goran-mahovlic/ulx3s-extensions/OV7670/OV7670.kicad_pcb

## KiCad design OV7670/OV7670.kicad_pcb (2023-08-24)

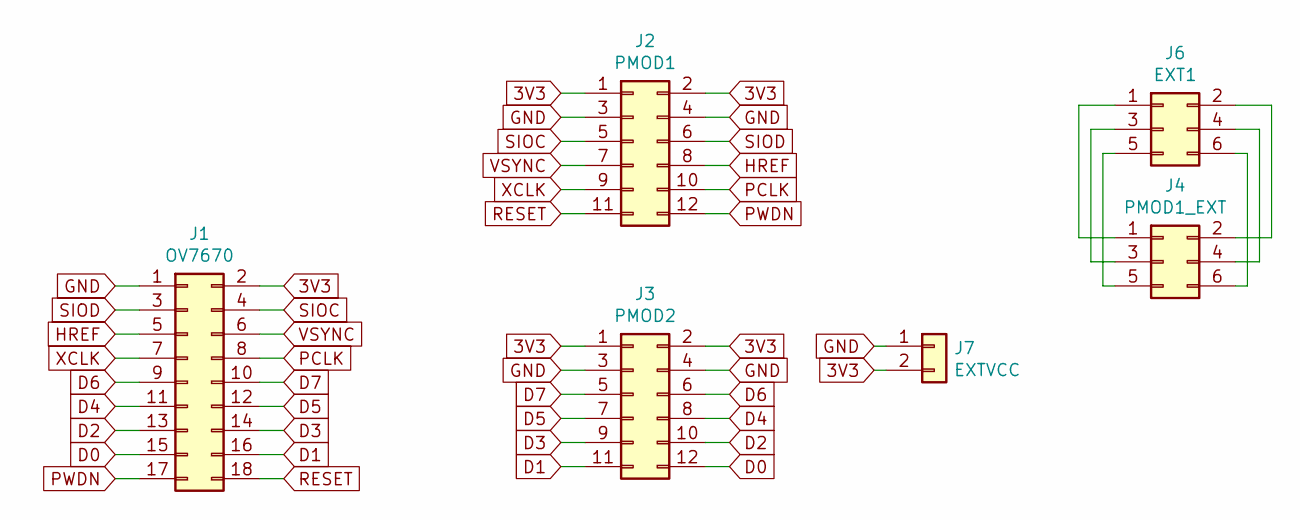
[picture p3: schematic OV7670.kicad_sch]

Parts:
J1: OV7670; PinSocket_2x09_P2.54mm_Vertical
J2: PMOD1; PinHeader_2x06_P2.54mm_Horizontal
J3: PMOD2; PinHeader_2x06_P2.54mm_Horizontal
J4: PMOD1_EXT; PinHeader_2x03_P2.54mm_Horizontal
J6: EXT1; PinHeader_2x03_P2.54mm_Vertical
J7: EXTVCC; PinHeader_1x02_P2.54mm_Vertical

Connections:
3V3: J1.2, J2.1, J2.2, J3.1, J3.2, J7.2
D0: J1.15, J3.12
D1: J1.16, J3.11
D2: J1.13, J3.10
D3: J1.14, J3.9
D4: J1.11, J3.8
D5: J1.12, J3.7
D6: J1.9, J3.6
D7: J1.10, J3.5
GND: J1.1, J2.3, J2.4, J3.3, J3.4, J7.1
HREF: J1.5, J2.8
unnamed: J4.1, J6.1
unnamed: J4.2, J6.2
unnamed: J4.3, J6.3
unnamed: J4.4, J6.4
unnamed: J4.5, J6.5
unnamed: J4.6, J6.6
PCLK: J1.8, J2.10
PWDN: J1.17, J2.12
RESET: J1.18, J2.11
SIOC: J1.4, J2.5
SIOD: J1.3, J2.6
VSYNC: J1.6, J2.7
XCLK: J1.7, J2.9

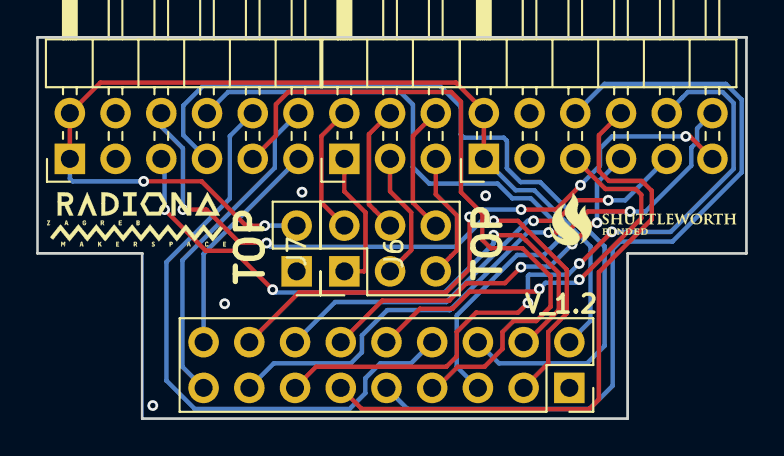
[picture p4: board OV7670.kicad_pcb from above]

Board: 4 copper layers, 39.4 x 21.2 mm, 6 parts (0 on the bottom side), 24 nets.
