goran-mahovlic/ulx3s-extensions/GPDI_ULX3S/GPDI_ULX3S.kicad_pcb

## KiCad design GPDI_ULX3S/GPDI_ULX3S.kicad_pcb (2023-08-23)

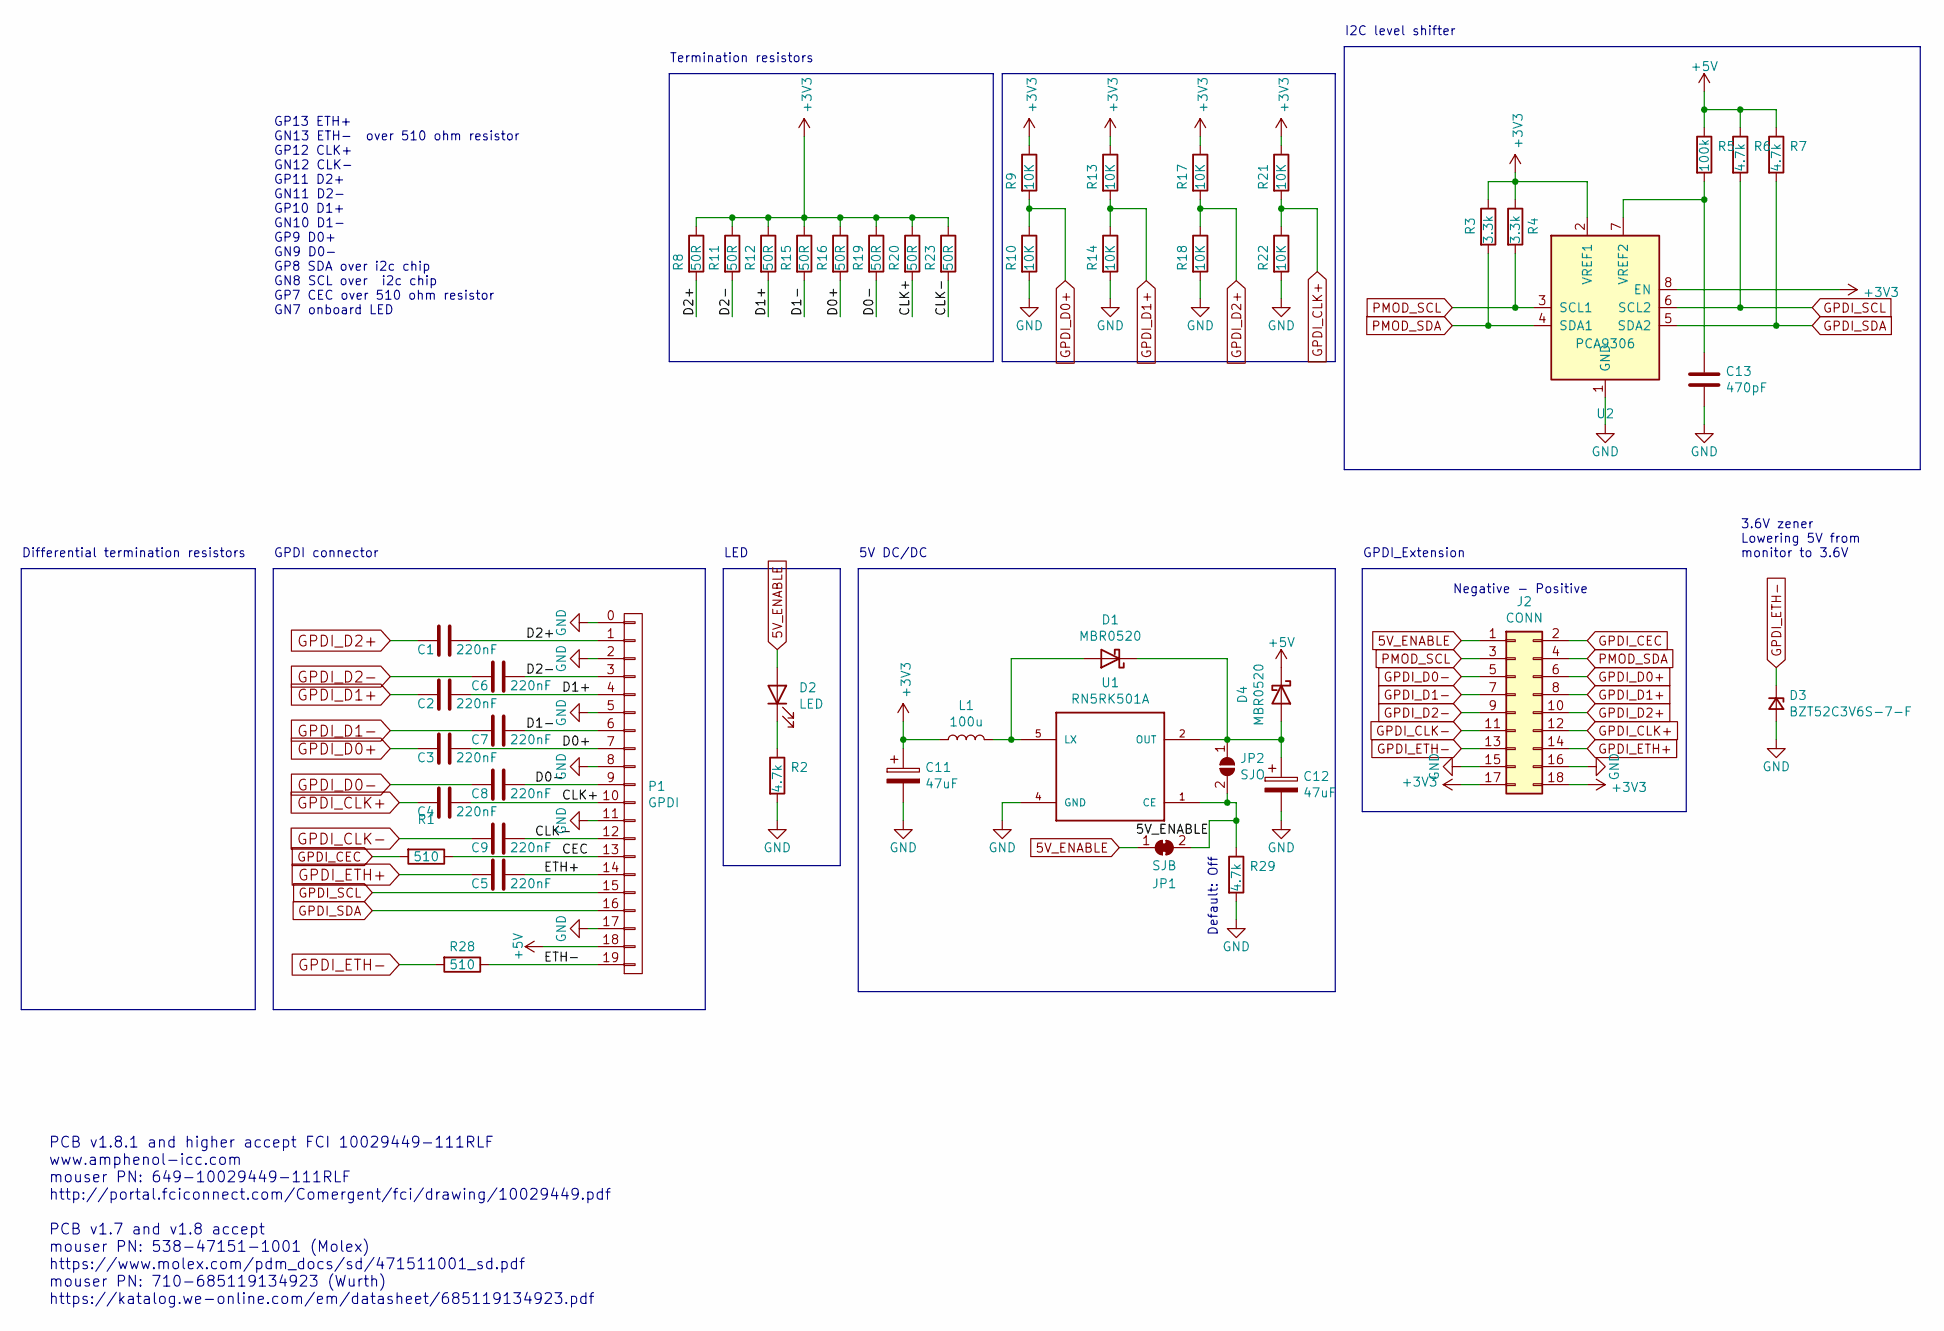
[picture p5: schematic GPDI_ULX3S.kicad_sch, GPDI extension for ULX3S]

Parts:
C1, C2, C3, C4, C5, C6, C7, C8, C9: 220nF; C_0402_1005Metric
C11, C12: 47uF; CP_EIA-3216-10_Kemet-I
C13: 470pF; C_0402_1005Metric
D1, D4: MBR0520; D_SOD-123
D2: LED; LED_0603_1608Metric_Pad1.05x0.95mm_HandSolder
D3: BZT52C3V6S-7-F; D_SOD-323
J2: CONN; PinHeader_2x09_P2.54mm_Horizontal
JP1: SJB; SolderJumper-2_P1.3mm_Bridged_RoundedPad1.0x1.5mm
JP2: SJO; SolderJumper-2_P1.3mm_Open_RoundedPad1.0x1.5mm
L1: 100u; L_1210_3225Metric
P1: GPDI; CONN-10029449-111RLF
R1, R28: 510; R_0402_1005Metric
R2, R6, R7, R29: 4.7k; R_0402_1005Metric
R3, R4: 3.3k; R_0402_1005Metric
R5: 100k; R_0402_1005Metric
R8, R11, R12, R15, R16, R19, R20, R23: 50R; R_0402_1005Metric
R9, R10, R13, R14, R17, R18, R21, R22: 10K; R_0402_1005Metric
U1: RN5RK501A; SOT-23-5
U2: PCA9306; SOP65P400X130-8N

Connections:
5V_ENABLE: D2.2 (A), J2.1, JP1.1 (A), JP1.2 (B), JP2.2 (B), R29.1, U1.1 (CE)
+3V3: C11.1, J2.17, J2.18, L1.1, R3.1, R4.1, R8.1, R9.1, R11.1, R12.1, R13.1, R15.1, R16.1, R17.1, R19.1, R20.1, R21.1, R23.1, U2.2 (VREF1), U2.8 (EN)
+5V: D4.1 (K), P1.18, R5.1, R6.1, R7.1
/CEC: P1.13, R1.1
/CLK+: C4.2, P1.10, R20.2
/CLK-: C9.2, P1.12, R23.2
/D0+: C3.2, P1.7, R16.2
/D0-: C8.2, P1.9, R19.2
/D1+: C2.2, P1.4, R12.2
/D1-: C7.2, P1.6, R15.2
/D2+: C1.2, P1.1, R8.2
/D2-: C6.2, P1.3, R11.2
/ETH+: C5.2, P1.14
/ETH-: P1.19, R28.1
GND: C11.2, C12.2, C13.2, D3.2 (A), J2.15, J2.16, P1.0, P1.2, P1.5, P1.8, P1.11, P1.17, R2.2, R10.2, R14.2, R18.2, R22.2, R29.2, U1.4 (GND), U2.1 (GND)
GPDI_CEC: J2.2, R1.2
GPDI_CLK+: C4.1, J2.12, R21.2, R22.1
GPDI_CLK-: C9.1, J2.11
GPDI_D0+: C3.1, J2.6, R9.2, R10.1
GPDI_D0-: C8.1, J2.5
GPDI_D1+: C2.1, J2.8, R13.2, R14.1
GPDI_D1-: C7.1, J2.7
GPDI_D2+: C1.1, J2.10, R17.2, R18.1
GPDI_D2-: C6.1, J2.9
GPDI_ETH+: C5.1, J2.14
GPDI_ETH-: D3.1 (K), J2.13, R28.2
GPDI_SCL: P1.15, R6.2, U2.6 (SCL2)
GPDI_SDA: P1.16, R7.2, U2.5 (SDA2)
unnamed: D1.2 (A), L1.2, U1.5 (LX)
unnamed: C12.1, D1.1 (K), D4.2 (A), JP2.1 (A), U1.2 (OUT)
unnamed: D2.1 (K), R2.1
unnamed: C13.1, R5.2, U2.7 (VREF2)
PMOD_SCL: J2.3, R4.2, U2.3 (SCL1)
PMOD_SDA: J2.4, R3.2, U2.4 (SDA1)

Notes on the sheet:
GPDI_Extension
5V DC/DC
Termination resistors
GPDI connector
Differential termination resistors
I2C level shifter
Default: Off
GP13 ETH+ GN13 ETH- over 510 ohm resistor GP12 CLK+ GN12 CLK- GP11 D2+ GN11 D2- GP10 D1+ GN10 D1- GP9 D0+ GN9 D0- GP8 SDA over i2c chip GN8 SCL over i2c chip GP7 CEC over 510 ohm resistor GN7 onboard LED
3.6V zener Lowering 5V from monitor to 3.6V
PCB v1.8.1 and higher accept FCI 10029449-111RLF www.amphenol-icc.com mouser PN: 649-10029449-111RLF http://portal.fciconnect.com/Comergent/fci/drawing/10029449.pdf PCB v1.7 and v1.8 accept mouser PN: 538-47151-1001 (Molex) https://www.molex.com/pdm_docs/sd/471511001_sd.pdf mouser PN: 710-685119134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
LED
Negative - Positive

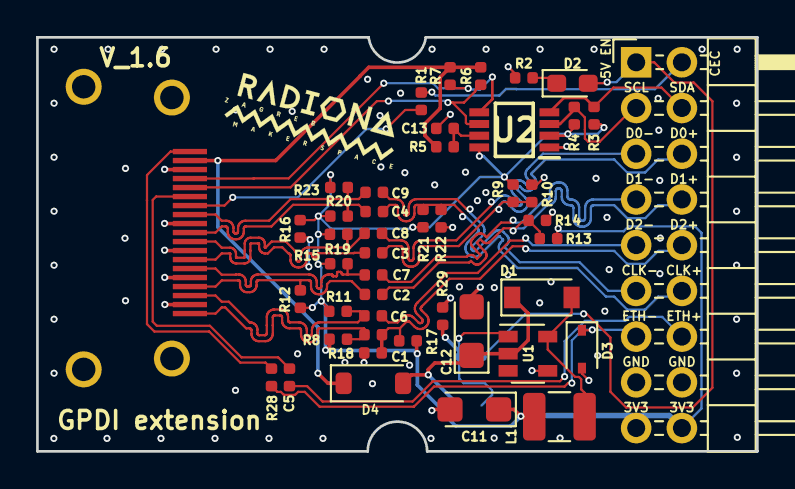
[picture p6: board GPDI_ULX3S/GPDI_ULX3S.kicad_pcb from above]

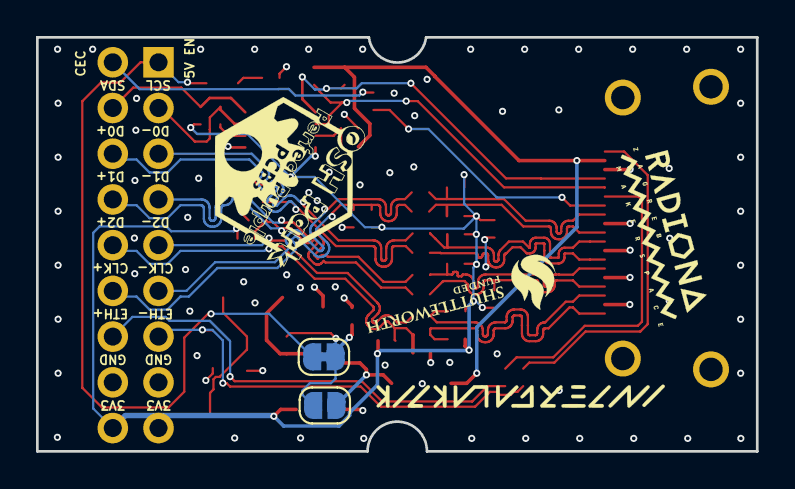
[picture p7: board GPDI_ULX3S/GPDI_ULX3S.kicad_pcb from below]

Board: 4 copper layers, 40.0 x 23.0 mm, 48 parts (2 on the bottom side), 34 nets.
