goran-mahovlic/ulx3s-extensions/MIDI/midi.kicad_pcb

## KiCad design MIDI/midi.kicad_pcb (2021-02-04)

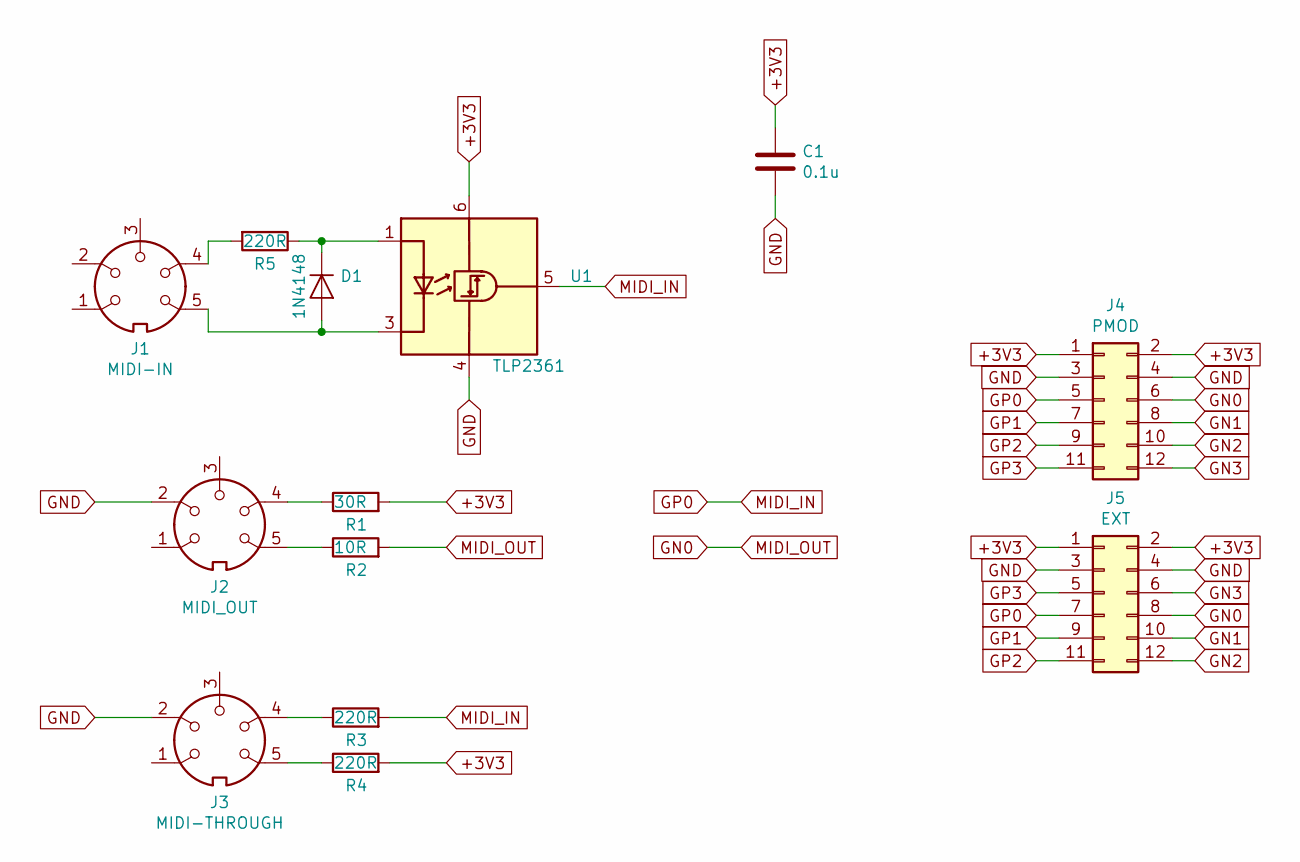
[picture p8: schematic midi.sch]

Parts:
C1: 0.1u; C_0603_1608Metric
D1: 1N4148; D_0603_1608Metric
J1: MIDI-IN; CUI_SDS-50J
J2: MIDI_OUT; CUI_SDS-50J
J3: MIDI-THROUGH; CUI_SDS-50J
J4: PMOD; PinHeader_2x06_P2.54mm_Horizontal
J5: EXT; PinSocket_2x06_P2.54mm_Horizontal
R1: 30R; R_0603_1608Metric
R2: 10R; R_0603_1608Metric
R3, R4, R5: 220R; R_0603_1608Metric
U1: TLP2361; SO-6_4.4x3.6mm_P1.27mm

Connections:
+3V3: C1.1, J4.1, J4.2, J5.1, J5.2, R1.2, R4.2, U1.6 (VDD)
GN0: J4.6, J5.8, R2.2
GN1: J4.8, J5.10
GN2: J4.10, J5.12
GN3: J4.12, J5.6
GND: C1.2, J2.2, J3.2, J4.3, J4.4, J5.3, J5.4, U1.4 (GND)
GP0: J4.5, J5.7, R3.2, U1.5 (VO)
GP1: J4.7, J5.9
GP2: J4.9, J5.11
GP3: J4.11, J5.5
unnamed: D1.1 (K), R5.1, U1.1 (A)
unnamed: D1.2 (A), J1.5, U1.3 (K)
unnamed: J1.4, R5.2
unnamed: J2.4, R1.1
unnamed: J2.5, R2.1
unnamed: J3.4, R3.1
unnamed: J3.5, R4.1

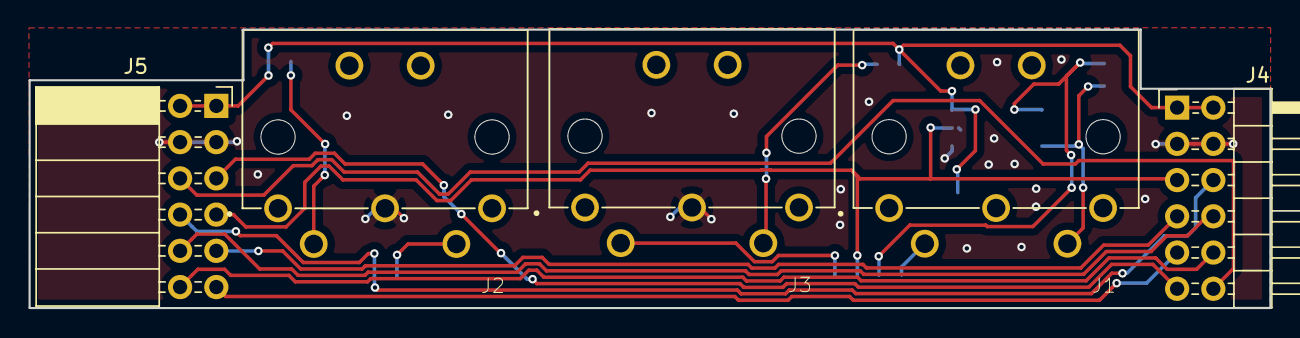
[picture p9: board midi.kicad_pcb from above]

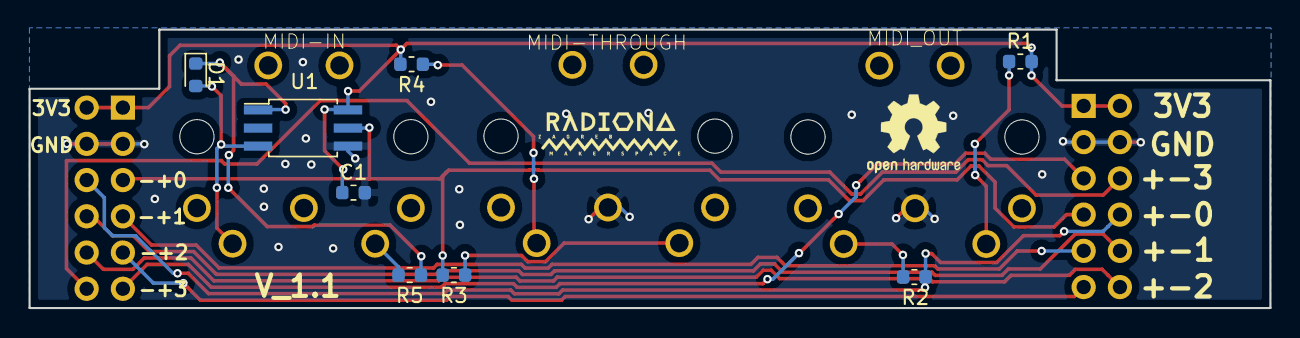
[picture p10: board midi.kicad_pcb from below]

Board: 2 copper layers, 87.0 x 19.5 mm, 13 parts (8 on the bottom side), 17 nets.
