goran-mahovlic/ulx3s-extensions/GPDI_empty_ULX3S/GPDI_ULX3S.kicad_pcb

## KiCad design GPDI_empty_ULX3S/GPDI_ULX3S.kicad_pcb (2021-01-29)

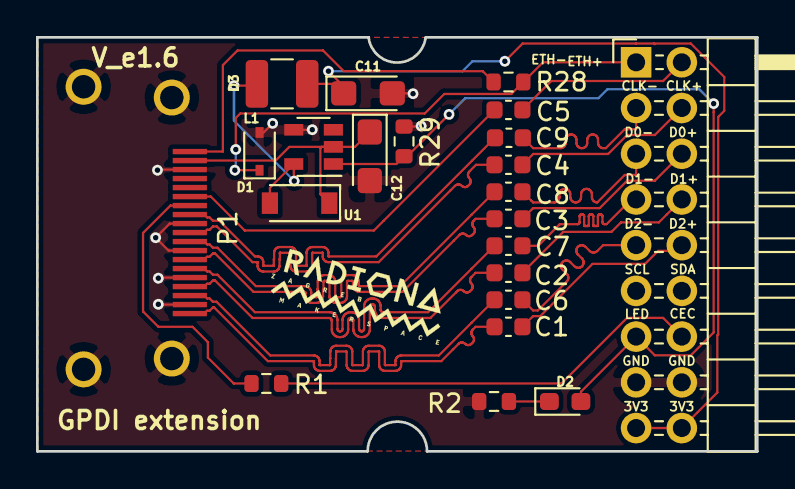
[picture p11: board GPDI_empty_ULX3S/GPDI_ULX3S.kicad_pcb from above]

Board: 2 copper layers, 40.0 x 23.0 mm, 22 parts (0 on the bottom side), 28 nets.

Parts:
C1, C2, C3, C4, C5, C6, C7, C8, C9: 22nF; C_0603_1608Metric
C11, C12: 47uF; CP_EIA-3216-10_Kemet-I
D1: MBR0520; D_SOD-123
D2: LED; LED_0603_1608Metric_Pad1.05x0.95mm_HandSolder
D3: BZT52C3V6S-7-F; D_SOD-323
J2: CONN; PinHeader_2x09_P2.54mm_Horizontal
L1: 100u; L_1210_3225Metric
P1: GPDI; CONN-10029449-111RLF
R1, R28: 510; R_0603_1608Metric
R2, R29: 4.7k; R_0603_1608Metric
U1: RN5RK501A; SOT-23-5

Connections:
+3V3: C11.1, J2.17, J2.18, L1.1
+5V: C12.1, D1.1, P1.18, U1.2
/CEC: P1.13, R1.1
/CLK+: C4.2, P1.10
/CLK-: C9.2, P1.12
/D0+: C3.2, P1.7
/D0-: C8.2, P1.9
/D1+: C2.2, P1.4
/D1-: C7.2, P1.6
/D2+: C1.2, P1.1
/D2-: C6.2, P1.3
/ETH+: C5.2, P1.14
/ETH-: P1.19, R28.1
GND: C11.2, C12.2, D3.2, J2.15, J2.16, P1.0, P1.2, P1.5, P1.8, P1.11, P1.17, R2.2, R29.2, U1.4
GPDI_CEC: J2.14, R1.2
GPDI_CLK+: C4.1, J2.4
GPDI_CLK-: C9.1, J2.3
GPDI_D0+: C3.1, J2.6
GPDI_D0-: C8.1, J2.5
GPDI_D1+: C2.1, J2.8
GPDI_D1-: C7.1, J2.7
GPDI_D2+: C1.1, J2.10
GPDI_D2-: C6.1, J2.9
GPDI_ETH+: C5.1, J2.2
GPDI_ETH-: D3.1, J2.1, R28.2
LED_HDMI: D2.2, J2.13, R29.1, U1.1
unnamed: D1.2, L1.2, U1.5
unnamed: D2.1, R2.1
