goran-mahovlic/ulx3s-extensions/LoRa/LoRa.kicad_pcb

## KiCad design LoRa/LoRa.kicad_pcb (2018-12-15)

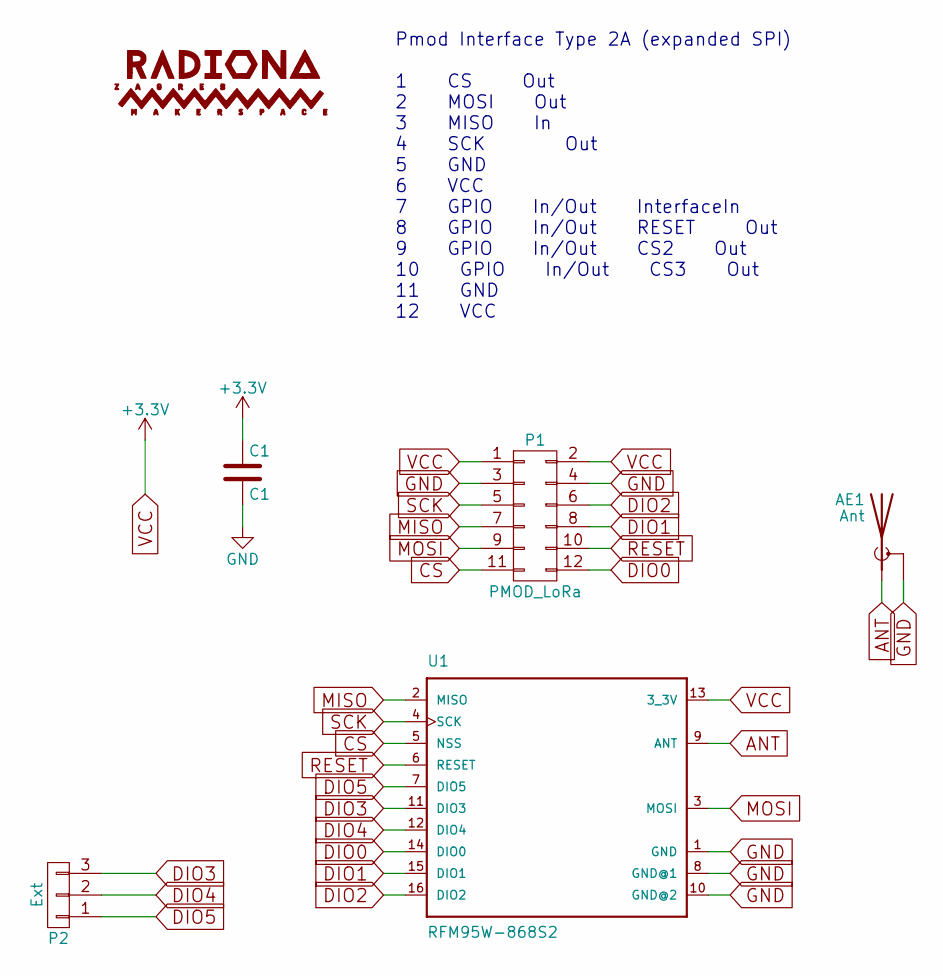
[picture p12: schematic LoRa.sch]

Parts:
AE1: Ant; SMB_Straight
C1: C1; C_0805_HandSoldering
P1: PMOD_LoRa; Pin_Header_Angled_2x06
P2: Ext; Pin_Header_Straight_1x03_Pitch2.00mm
U1: RFM95W-868S2; XCVR_RFM95W-868S2

Connections:
ANT: AE1.1 (A), U1.9 (ANT)
CS: P1.11, U1.5 (NSS)
DIO0: P1.12, U1.14 (DIO0)
DIO1: P1.8, U1.15 (DIO1)
DIO2: P1.6, U1.16 (DIO2)
DIO3: P2.3, U1.11 (DIO3)
DIO4: P2.2, U1.12 (DIO4)
DIO5: P2.1, U1.7 (DIO5)
GND: AE1.2 (Shield), C1.2, P1.3, P1.4, U1.1 (GND), U1.8 (GND@1), U1.10 (GND@2)
MISO: P1.7, U1.2 (MISO)
MOSI: P1.9, U1.3 (MOSI)
RESET: P1.10, U1.6 (RESET)
SCK: P1.5, U1.4 (SCK)
VCC: C1.1, P1.1, P1.2, U1.13 (3_3V)

Notes on the sheet:
Pmod Interface Type 2A (expanded SPI) 1 CS Out 2 MOSI Out 3 MISO In 4 SCK Out 5 GND 6 VCC 7 GPIO In/Out InterfaceIn 8 GPIO In/Out RESET Out 9 GPIO In/Out CS2 Out 10 GPIO In/Out CS3 Out 11 GND 12 VCC

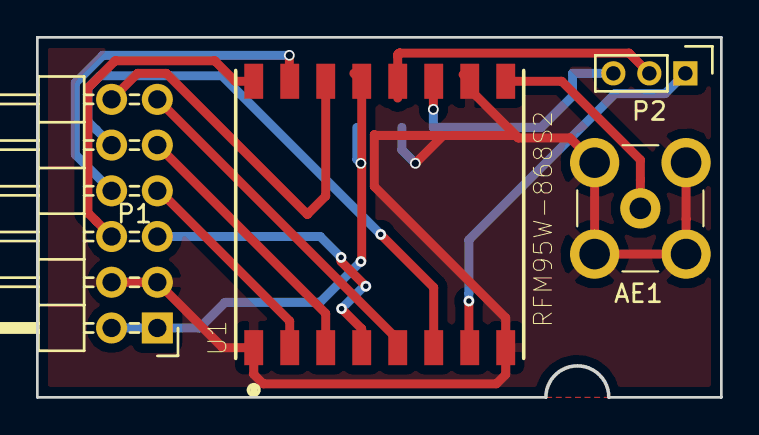
[picture p13: board LoRa.kicad_pcb from above]

Board: 2 copper layers, 38.0 x 20.0 mm, 5 parts (1 on the bottom side), 14 nets.
