goran-mahovlic/ulx3s-extensions/ENC28J60/ENC28J60/ENC28J60.kicad_pcb

## KiCad design ENC28J60/ENC28J60/ENC28J60.kicad_pcb (2021-01-29)

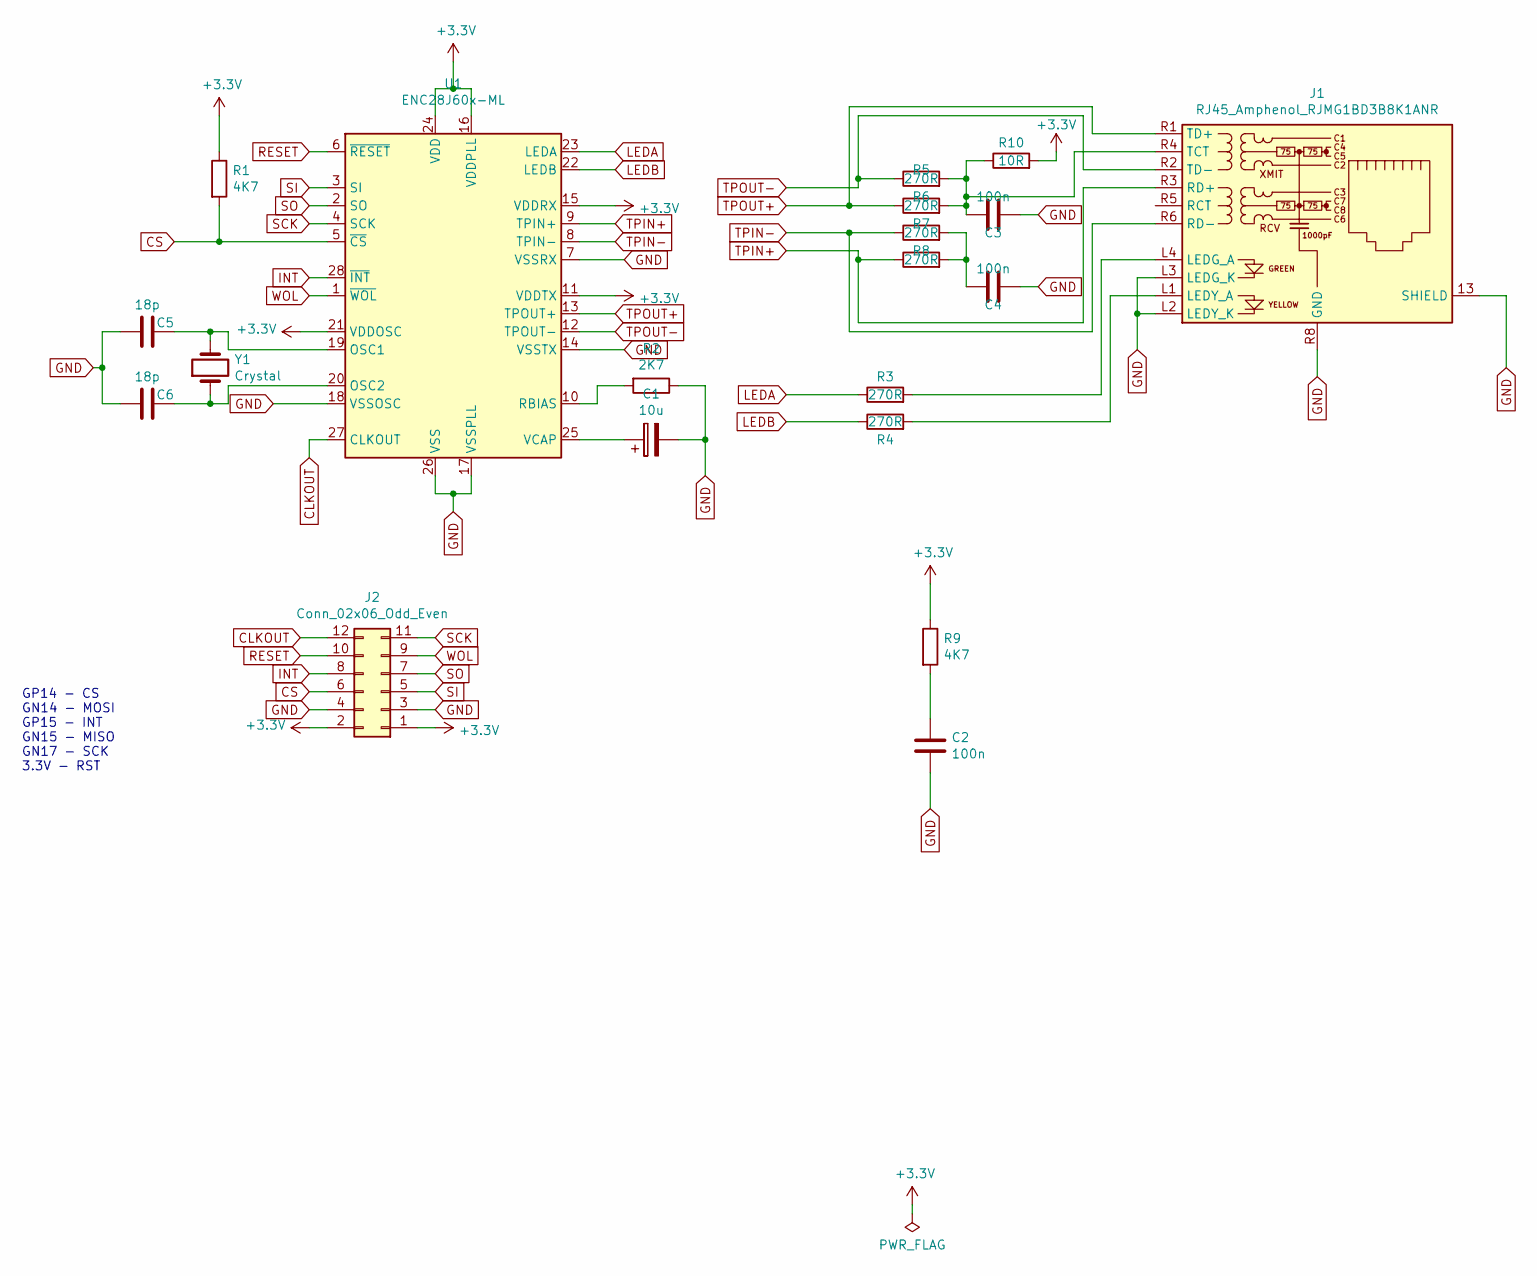
[picture p14: schematic ENC28J60.sch]

Parts:
C1: 10u; CP_EIA-1608-08_AVX-J_Pad1.25x1.05mm_HandSolder
C2, C3, C4: 100n; C_0603_1608Metric_Pad1.05x0.95mm_HandSolder
C5, C6: 18p; C_0603_1608Metric_Pad1.05x0.95mm_HandSolder
J1: RJ45_Amphenol_RJMG1BD3B8K1ANR
J2: Conn_02x06_Odd_Even; PinHeader_2x06_P2.54mm_Horizontal
R1, R9: 4K7; R_0603_1608Metric_Pad1.05x0.95mm_HandSolder
R2: 2K7; R_0603_1608Metric_Pad1.05x0.95mm_HandSolder
R3, R4, R5, R6, R7, R8: 270R; R_0603_1608Metric_Pad1.05x0.95mm_HandSolder
R10: 10R; R_0603_1608Metric_Pad1.05x0.95mm_HandSolder
U1: ENC28J60x-ML; QFN-28-1EP_6x6mm_P0.65mm_EP4.25x4.25mm
Y1: Crystal; Crystal_SMD_SeikoEpson_FA238-4Pin_3.2x2.5mm

Connections:
+3V3: J2.1, J2.2, R1.1, R9.1, R10.2, U1.11 (VDDTX), U1.15 (VDDRX), U1.16 (VDDPLL), U1.21 (VDDOSC), U1.24 (VDD)
CLKOUT: J2.12, U1.27 (CLKOUT)
CS: J2.6, R1.2, U1.5 (~CS)
GND: C1.2, C2.2, C3.1, C4.1, C5.2, C6.2, J1.13 (SHIELD), J1.L2 (LEDY_K), J1.L3 (LEDG_K), J1.R8 (GND), J2.3, J2.4, R2.1, U1.7 (VSSRX), U1.14 (VSSTX), U1.17 (VSSPLL), U1.18 (VSSOSC), U1.26 (VSS)
INT: J2.8, U1.28 (~INT)
LEDA: R3.1, U1.23 (LEDA)
LEDB: R4.1, U1.22 (LEDB)
unnamed: C1.1, U1.25 (VCAP)
unnamed: C2.1, R9.2
unnamed: C3.2, J1.R4 (TCT), R5.2, R6.2, R10.1
unnamed: C4.2, R7.2, R8.2
unnamed: C5.1, U1.19 (OSC1), Y1.2
unnamed: C6.1, U1.20 (OSC2), Y1.1
unnamed: J1.L1 (LEDY_A), R4.2
unnamed: J1.L4 (LEDG_A), R3.2
unnamed: R2.2, U1.10 (RBIAS)
RESET: J2.10, U1.6 (~RESET)
SCK: J2.11, U1.4 (SCK)
SI: J2.5, U1.3 (SI)
SO: J2.7, U1.2 (SO)
TPIN+: J1.R3 (RD+), R8.1, U1.9 (TPIN+)
TPIN-: J1.R6 (RD-), R7.1, U1.8 (TPIN-)
TPOUT+: J1.R1 (TD+), R6.1, U1.13 (TPOUT+)
TPOUT-: J1.R2 (TD-), R5.1, U1.12 (TPOUT-)
WOL: J2.9, U1.1 (~WOL)

Notes on the sheet:
GP14 - CS GN14 - MOSI GP15 - INT GN15 - MISO GN17 - SCK 3.3V - RST

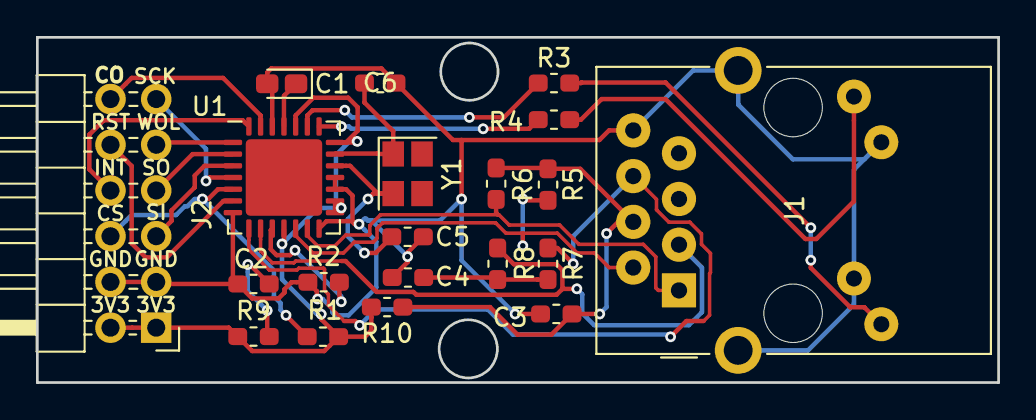
[picture p15: board ENC28J60.kicad_pcb from above]

Board: 2 copper layers, 53.4 x 19.2 mm, 20 parts (0 on the bottom side), 25 nets.
