goran-mahovlic/ulx3s-extensions/Encoders/Poteciometers.kicad_pcb

## KiCad design Encoders/Poteciometers.kicad_pcb (2021-01-29)

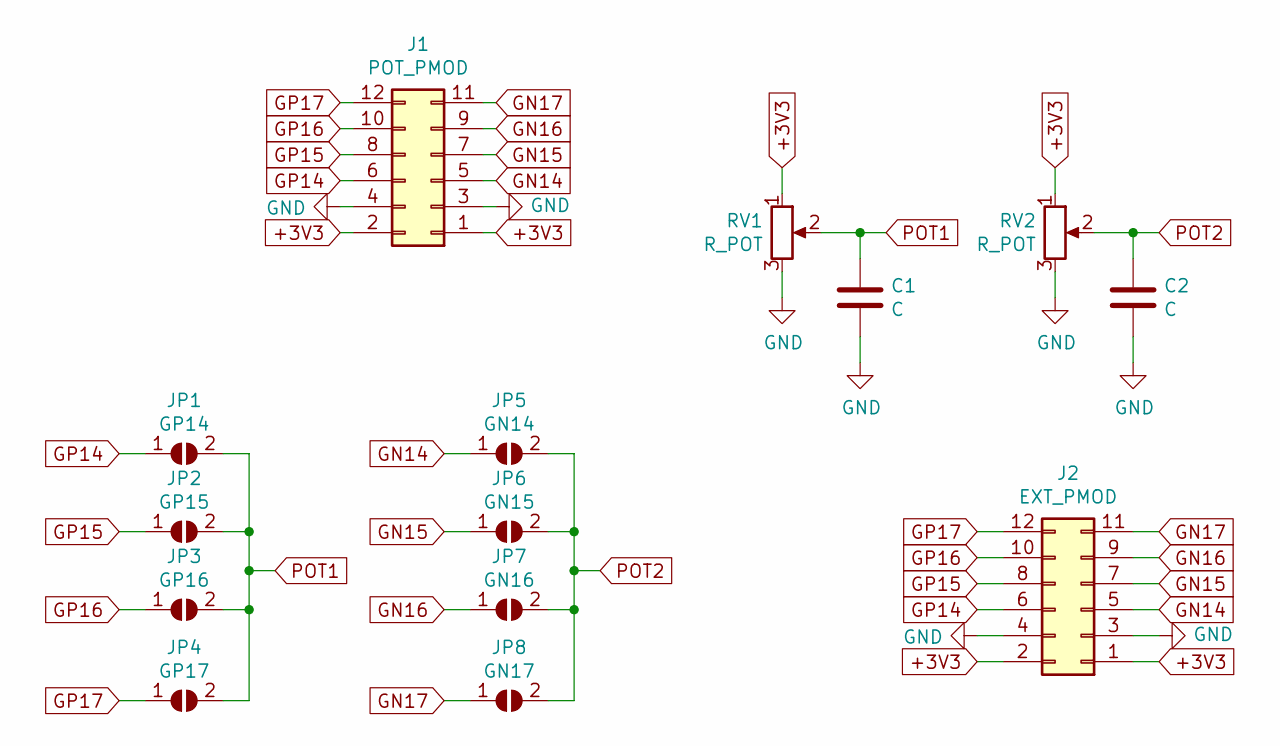
[picture p16: schematic Poteciometers.sch]

Parts:
C1, C2: C; C_0603_1608Metric
J1: POT_PMOD; PinHeader_2x06_P2.54mm_Horizontal
J2: EXT_PMOD; PinSocket_2x06_P2.54mm_Horizontal
JP1: GP14; SolderJumper-2_P1.3mm_Open_TrianglePad1.0x1.5mm
JP2: GP15; SolderJumper-2_P1.3mm_Open_TrianglePad1.0x1.5mm
JP3: GP16; SolderJumper-2_P1.3mm_Open_TrianglePad1.0x1.5mm
JP4: GP17; SolderJumper-2_P1.3mm_Open_TrianglePad1.0x1.5mm
JP5: GN14; SolderJumper-2_P1.3mm_Open_TrianglePad1.0x1.5mm
JP6: GN15; SolderJumper-2_P1.3mm_Open_TrianglePad1.0x1.5mm
JP7: GN16; SolderJumper-2_P1.3mm_Open_TrianglePad1.0x1.5mm
JP8: GN17; SolderJumper-2_P1.3mm_Open_TrianglePad1.0x1.5mm
RV1, RV2: R_POT; Potentiometer_Alps_RK09K_Single_Vertical

Connections:
+3V3: J1.1, J1.2, J2.1, J2.2, RV1.1, RV2.1
GN14: J1.5, J2.5, JP5.1 (A)
GN15: J1.7, J2.7, JP6.1 (A)
GN16: J1.9, J2.9, JP7.1 (A)
GN17: J1.11, J2.11, JP8.1 (A)
GND: C1.2, C2.2, J1.3, J1.4, J2.3, J2.4, RV1.3, RV2.3
GP14: J1.6, J2.6, JP1.1 (A)
GP15: J1.8, J2.8, JP2.1 (A)
GP16: J1.10, J2.10, JP3.1 (A)
GP17: J1.12, J2.12, JP4.1 (A)
POT1: C1.1, JP1.2 (B), JP2.2 (B), JP3.2 (B), JP4.2 (B), RV1.2
POT2: C2.1, JP5.2 (B), JP6.2 (B), JP7.2 (B), JP8.2 (B), RV2.2

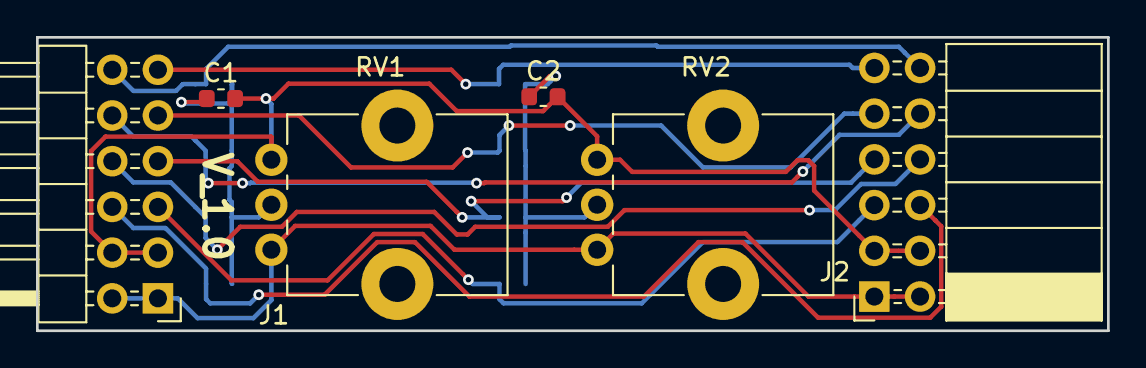
[picture p17: board Encoders/Poteciometers.kicad_pcb from above]

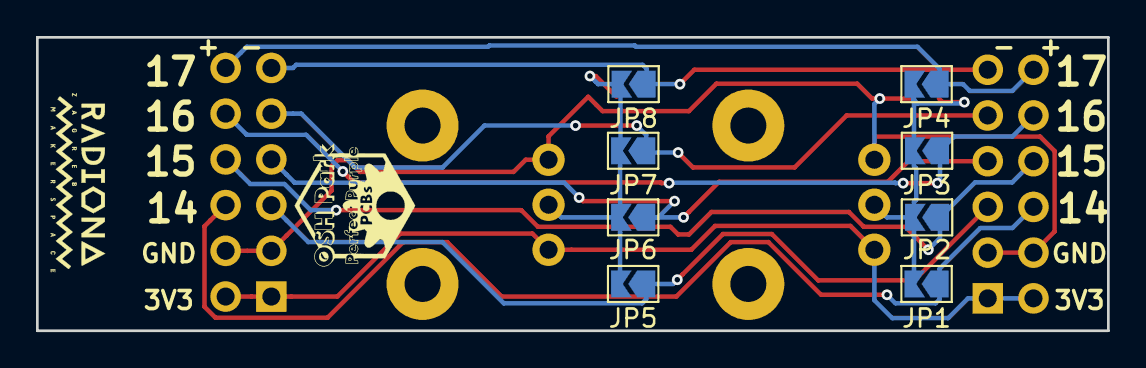
[picture p18: board Encoders/Poteciometers.kicad_pcb from below]

Board: 2 copper layers, 59.5 x 16.3 mm, 14 parts (8 on the bottom side), 12 nets.
