goran-mahovlic/ulx3s-extensions/VGA/VGA.kicad_pcb

## KiCad design VGA/VGA.kicad_pcb (2020-04-09)

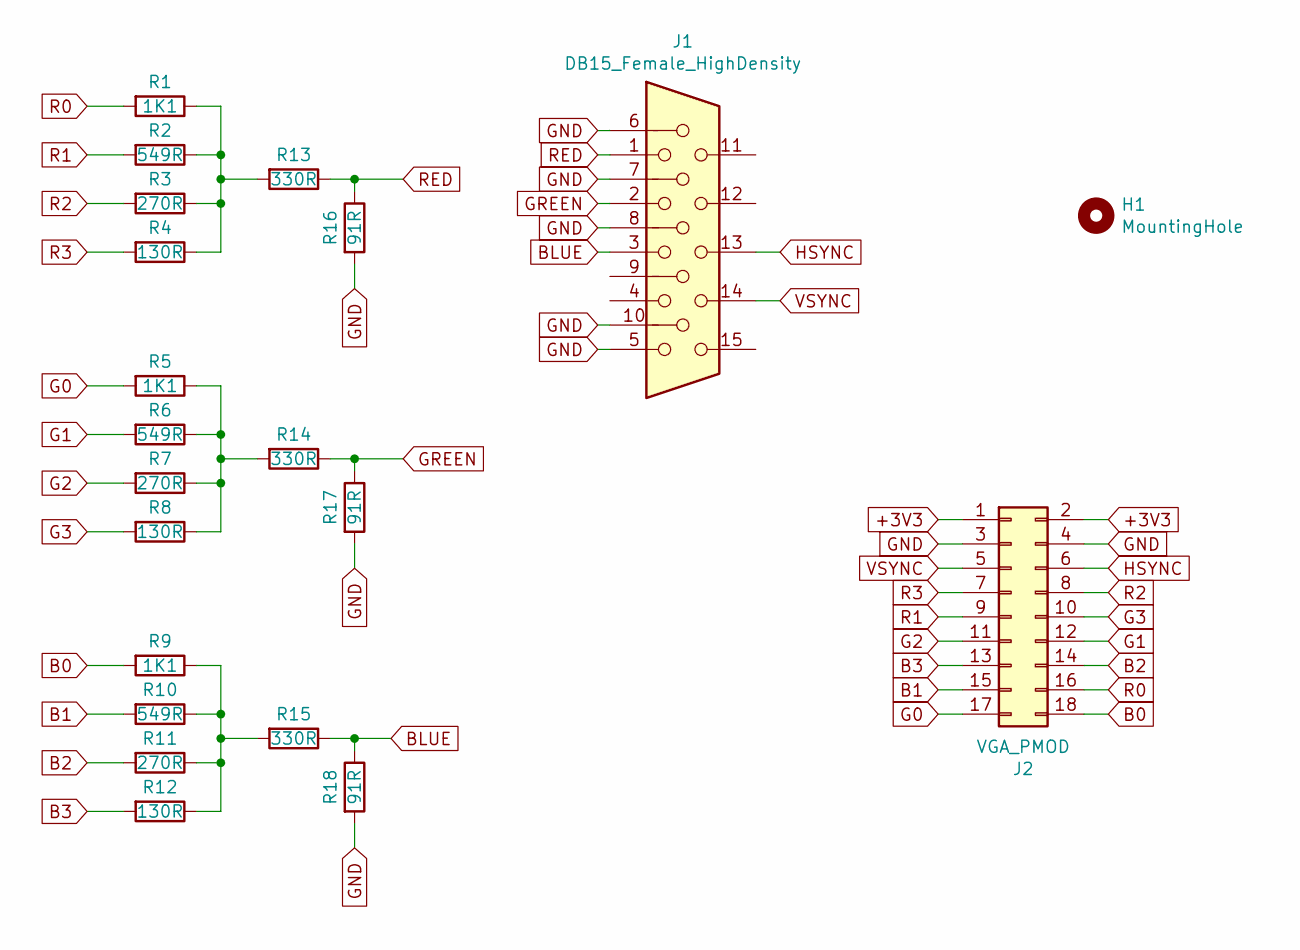
[picture p19: schematic VGA.sch]

Parts:
H1: MountingHole; MountingHole_3.5mm
J1: DB15_Female_HighDensity; DSUB-15-HD_Female_Horizontal_P2.29x1.98mm_EdgePinOffset3.03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
J2: VGA_PMOD; PinHeader_2x09_P2.54mm_Horizontal
R1, R5, R9: 1K1; R_0603_1608Metric
R2, R6, R10: 549R; R_0603_1608Metric
R3, R7, R11: 270R; R_0603_1608Metric
R4, R8, R12: 130R; R_0603_1608Metric
R13, R14, R15: 330R; R_0603_1608Metric
R16, R17, R18: 91R; R_0603_1608Metric

Connections:
+3V3: J2.1, J2.2
B0: J2.18, R9.2
B1: J2.15, R10.2
B2: J2.14, R11.2
B3: J2.13, R12.2
BLUE: J1.3, R15.1, R18.1
G0: J2.17, R5.2
G1: J2.12, R6.2
G2: J2.11, R7.2
G3: J2.10, R8.2
GND: J1.0, J1.5, J1.6, J1.7, J1.8, J1.10, J2.3, J2.4, R16.2, R17.2, R18.2
GREEN: J1.2, R14.1, R17.1
HSYNC: J1.13, J2.6
unnamed: R1.1, R2.1, R3.1, R4.1, R13.2
unnamed: R9.1, R10.1, R11.1, R12.1, R15.2
unnamed: R5.1, R6.1, R7.1, R8.1, R14.2
R0: J2.16, R1.2
R1: J2.9, R2.2
R2: J2.8, R3.2
R3: J2.7, R4.2
RED: J1.1, R13.1, R16.1
VSYNC: J1.14, J2.5

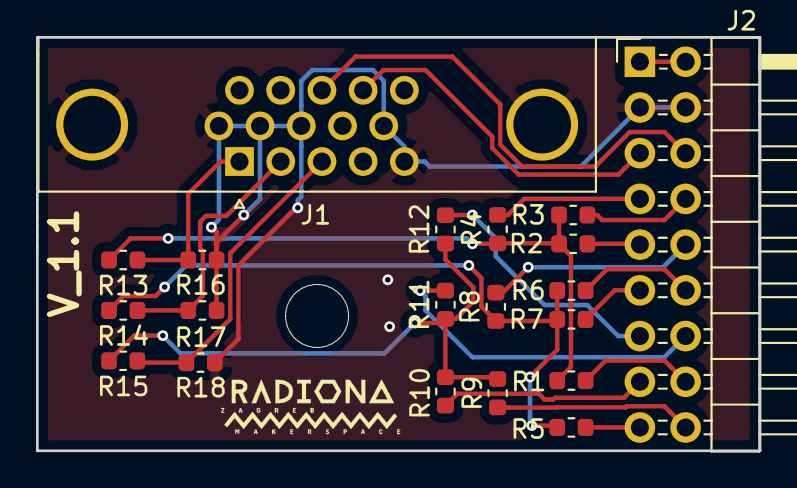
[picture p20: board VGA.kicad_pcb from above]

Board: 2 copper layers, 40.2 x 23.0 mm, 21 parts (0 on the bottom side), 22 nets.
