goran-mahovlic/ulx3s-extensions/Poteciometers/Poteciometers.kicad_pcb

## KiCad design Poteciometers/Poteciometers.kicad_pcb (2020-04-08, an earlier design)

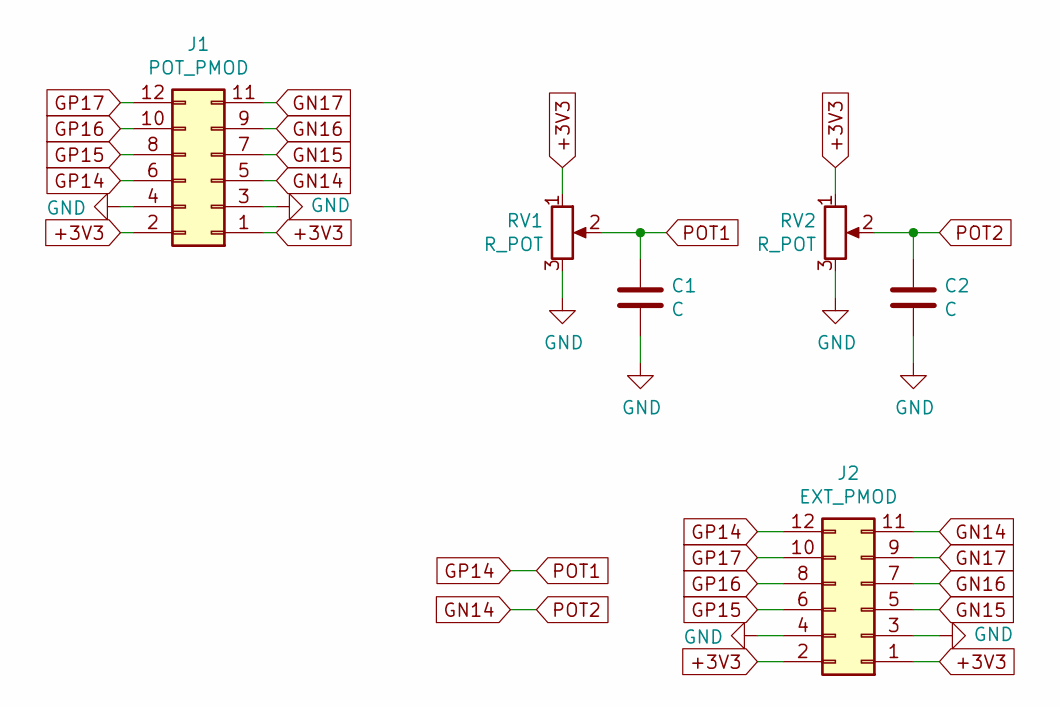
[picture p21: schematic Poteciometers.sch]

Parts:
C1, C2: C; C_0603_1608Metric
J1: POT_PMOD; PinHeader_2x06_P2.54mm_Horizontal
J2: EXT_PMOD; PinSocket_2x06_P2.54mm_Horizontal
RV1, RV2: R_POT; Potentiometer_Alps_RK09K_Single_Vertical

Connections:
+3V3: J1.1, J1.2, J2.1, J2.2, RV1.1, RV2.1
GN14: C2.1, J1.5, J2.11, RV2.2
GN15: J1.7, J2.5
GN16: J1.9, J2.7
GN17: J1.11, J2.9
GND: C1.2, C2.2, J1.3, J1.4, J2.3, J2.4, RV1.3, RV2.3
GP14: C1.1, J1.6, J2.12, RV1.2
GP15: J1.8, J2.6
GP16: J1.10, J2.8
GP17: J1.12, J2.10

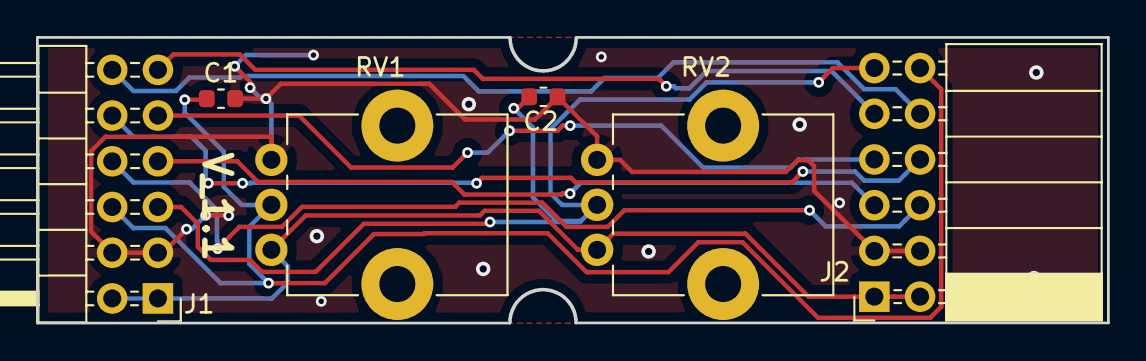
[picture p22: board Poteciometers/Poteciometers.kicad_pcb from above]

Board: 2 copper layers, 59.5 x 15.9 mm, 6 parts (0 on the bottom side), 10 nets.
