goran-mahovlic/ulx3s-extensions/DS90CF364/DS90CF364.kicad_pcb

## KiCad design DS90CF364/DS90CF364.kicad_pcb (2020-01-28)

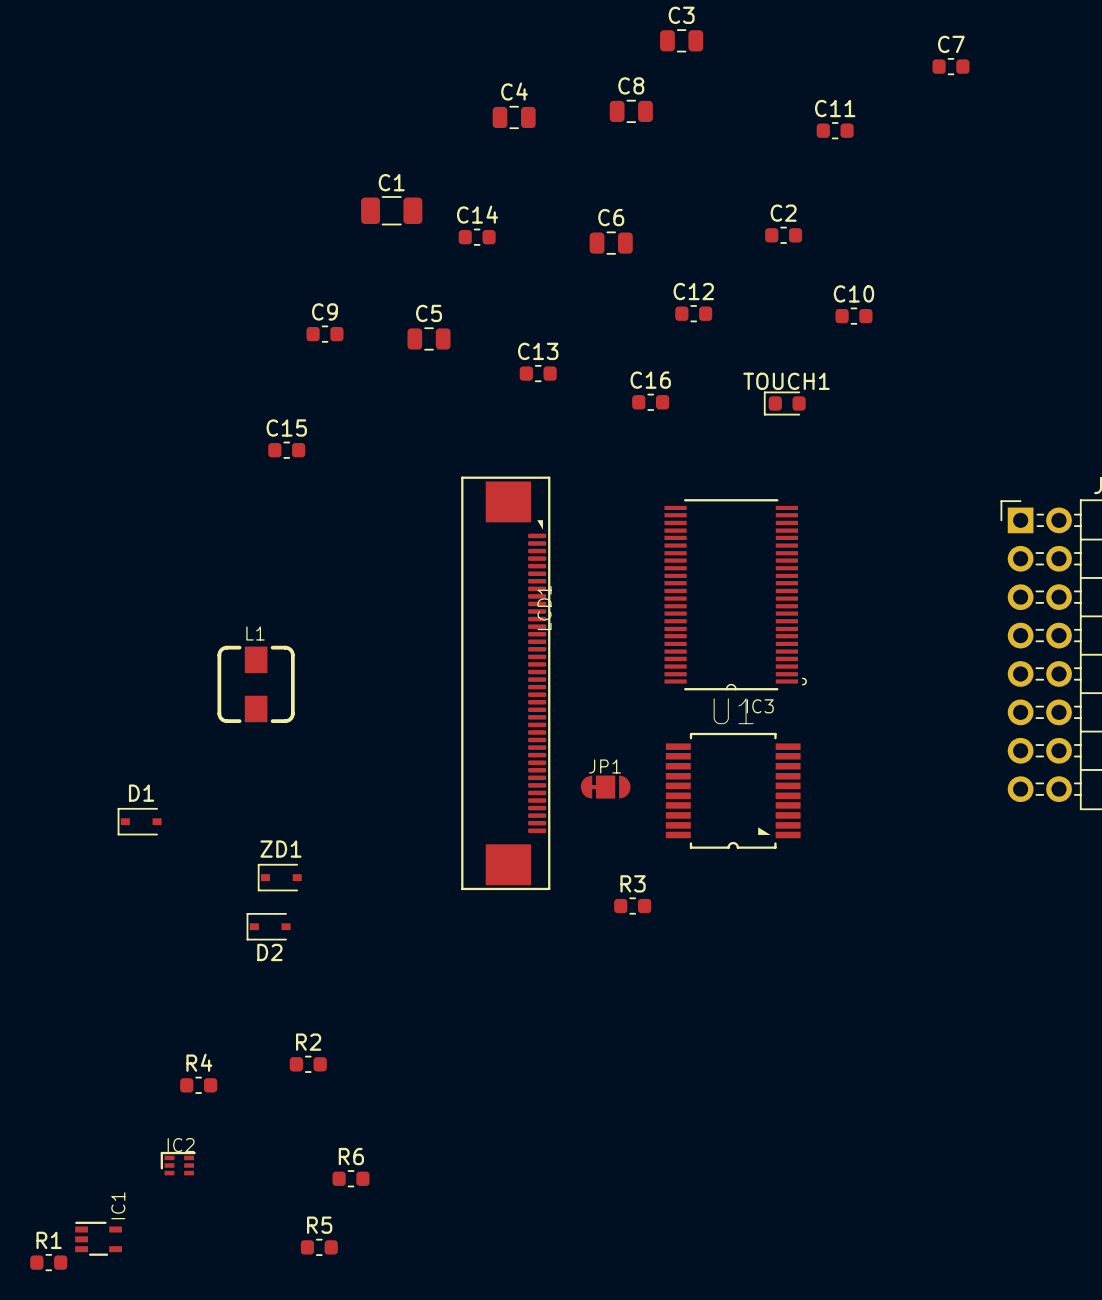
[picture p23: board DS90CF364.kicad_pcb from above]

Board: 2 copper layers, 34 parts (0 on the bottom side), 42 nets, no tracks yet.

Parts:
C1: 4u7; C_1206_3216Metric
C2, C7, C9, C10, C11, C12, C13, C14, C15, C16: 100n; C_0603_1608Metric
C3, C8: 1u; C_0805_2012Metric
C4, C6: 10n; C_0805_2012Metric
C5: 2u2; C_0805_2012Metric
D1: D_Schottky; D_SOD-323
D2: D_Zener; D_SOD-323
IC1: TPS61169DCKR; DCK5
IC2: TPD4E001DRLR; DRL6
IC3: AR1021-I/SS; SOP65P780X200-20N
J1: Conn_02x08_Odd_Even; PinHeader_2x08_P2.54mm_Horizontal
JP1: JP3-CUT
L1: DLG-0403-4R7; DE0403
LCD1: PCA-6-LA-40-HL-3; FPC_40
R1, R2: 10R; R_0603_1608Metric
R3: 10K; R_0603_1608Metric
R4: 20K; R_0603_1608Metric
R5: 4K7; R_0603_1608Metric
R6: 1K; R_0603_1608Metric
TOUCH1: LED; LED_0603_1608Metric
U1: DS90CF364AMTD; SOP50P800X110-48N
ZD1: BZX384-B30.115; D_SOD-323

Connections:
3V3: C1.1, C2.2, C5.1, C7.2, C8.2, C9.1, C10.1, C11.1, C12.1, C13.1, C14.1, C15.1, C16.1, IC2.6, IC3.1, J1.1, J1.2, L1.1, LCD1.4, R1.1, R3.2, R6.2, U1.12, U1.20, U1.28, U1.36, U1.42, U1.48
/LCD_DISP: LCD1.31, R3.1
/LTDC_CLK: LCD1.30, U1.23
/LTDC_DE: LCD1.34, U1.5
/LTDC_HSYNC: LCD1.32, U1.2
/LTDC_RESET: JP1.COM, LCD1.36
/LTDC_VSYNC: LCD1.33, U1.4
/Touch_XL: C6.1, IC2.4, IC3.19, LCD1.39, R4.2
/Touch_XR: IC2.1, IC3.18, LCD1.37
/Touch_YD: C4.1, IC2.2, IC3.16, LCD1.38
/Touch_YU: IC2.5, IC3.15, LCD1.40
/VLED_SW: D1.2, IC1.1, L1.2
GN4: IC3.11, J1.13
GN5: IC3.9, J1.15
GND: C1.2, C2.1, C3.2, C4.2, C5.2, C6.2, C7.1, C8.1, C9.2, C10.2, C11.2, C12.2, C13.2, C14.2, C15.2, C16.2, IC1.2, IC2.3, IC3.2, IC3.3, IC3.4, IC3.7, IC3.14, IC3.17, IC3.20, J1.3, J1.4, JP1.NO, LCD1.3, LCD1.5, LCD1.6, LCD1.13, LCD1.14, LCD1.21, LCD1.22, LCD1.29, R2.2, TOUCH1.1, U1.3, U1.7, U1.13, U1.18, U1.19, U1.21, U1.25, U1.32, U1.38, U1.44
GP4: IC3.13, J1.14
GP5: IC1.4, J1.16
LTDC_B2: LCD1.23, U1.41
LTDC_B3: LCD1.24, U1.43
LTDC_B4: LCD1.25, U1.45
LTDC_B5: LCD1.26, U1.46
LTDC_B6: LCD1.27, U1.47
LTDC_B7: LCD1.28, U1.1
LTDC_G2: LCD1.15, U1.33
LTDC_G3: LCD1.16, U1.34
LTDC_G4: LCD1.17, U1.35
LTDC_G5: LCD1.18, U1.37
LTDC_G6: LCD1.19, U1.39
LTDC_G7: LCD1.20, U1.40
LTDC_R2: LCD1.7, U1.24
LTDC_R3: LCD1.8, U1.26
LTDC_R4: LCD1.9, U1.27
LTDC_R5: LCD1.10, U1.29
LTDC_R6: LCD1.11, U1.30
LTDC_R7: LCD1.12, U1.31
unnamed: IC1.5, R1.2
unnamed: IC3.5, R4.1
unnamed: IC3.6, R5.2
unnamed: R5.1, TOUCH1.2
unnamed: R6.1, U1.22
VLED+: C3.1, D1.1, D2.1, LCD1.2
VLED-: D2.2, IC1.3, LCD1.1, R2.1
