goran-mahovlic/ulx3s-extensions/I2S_MIC/I2C_MIC.kicad_pcb

## KiCad design I2S_MIC/I2C_MIC.kicad_pcb (2019-12-24)

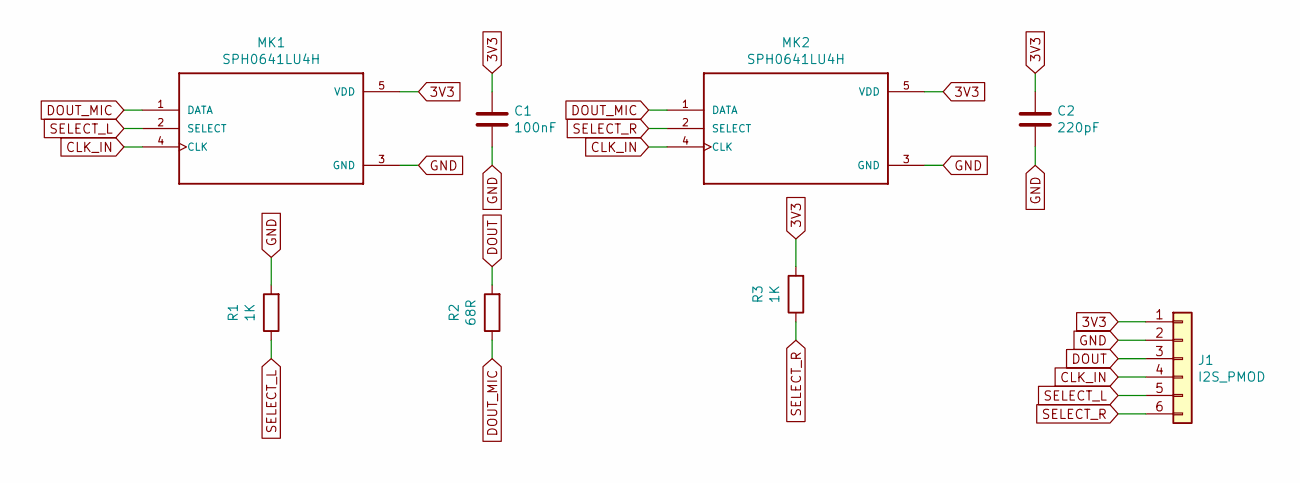
[picture p24: schematic I2C_MIC.sch]

Parts:
C1: 100nF; C_0603_1608Metric_Pad1.05x0.95mm_HandSolder
C2: 220pF; C_0603_1608Metric_Pad1.05x0.95mm_HandSolder
J1: I2S_PMOD; PinHeader_1x06_P2.54mm_Horizontal
MK1, MK2: SPH0641LU4H; MIC_SPH0645LM4H-B
R1, R3: 1K; R_0603_1608Metric_Pad1.05x0.95mm_HandSolder
R2: 68R; R_0603_1608Metric_Pad1.05x0.95mm_HandSolder

Connections:
3V3: C1.1, C2.1, J1.1, MK1.5 (VDD), MK2.5 (VDD), R3.2
CLK_IN: J1.4, MK1.4 (CLK), MK2.4 (CLK)
DOUT: J1.3, R2.2
DOUT_MIC: MK1.1 (DATA), MK2.1 (DATA), R2.1
GND: C1.2, C2.2, J1.2, MK1.3 (GND), MK2.3 (GND), R1.2
SELECT_L: J1.5, MK1.2 (SELECT), R1.1
SELECT_R: J1.6, MK2.2 (SELECT), R3.1

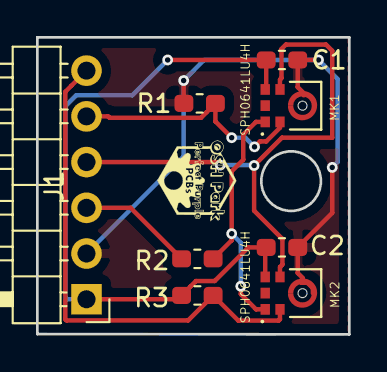
[picture p25: board I2C_MIC.kicad_pcb from above]

Board: 2 copper layers, 17.3 x 16.5 mm, 8 parts (0 on the bottom side), 7 nets.
