goran-mahovlic/ulx3s-extensions/MLX90640/MLX90640.kicad_pcb

## KiCad design MLX90640/MLX90640.kicad_pcb (2018-12-15)

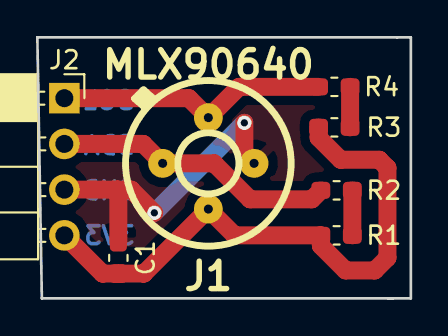
[picture p26: board MLX90640.kicad_pcb from above]

Board: 2 copper layers, 20.8 x 14.5 mm, 7 parts (0 on the bottom side), 6 nets.

Parts:
C1: 100nF; C_0603_1608Metric_Pad1.05x0.95mm_HandSolder
J1: MLX90640; TO-39
J2: PMOD_IN; PinSocket_1x04_P2.54mm_Horizontal
R1, R3: 0R; R_0603_1608Metric_Pad1.05x0.95mm_HandSolder
R2, R4: 4K7; R_0603_1608Metric_Pad1.05x0.95mm_HandSolder

Connections:
3V3: C1.1, J1.2, J2.4, R1.2, R3.2
GND: C1.2, J1.3, J2.3
unnamed: R1.1, R2.2
unnamed: R3.1, R4.2
SCL: J1.4, J2.1, R4.1
SDA: J1.1, J2.2, R2.1
