goran-mahovlic/ulx3s-extensions/I2S_Audio/I2S_Audio.kicad_pcb

## KiCad design I2S_Audio/I2S_Audio.kicad_pcb (2018-12-15)

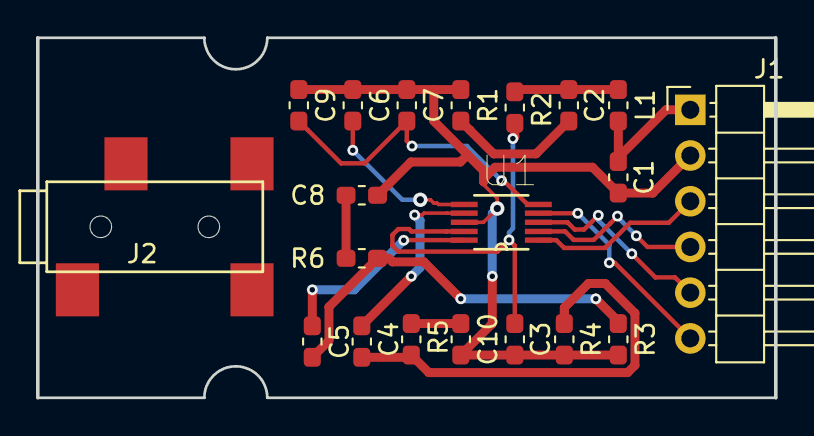
[picture p27: board I2S_Audio.kicad_pcb from above]

Board: 2 copper layers, 41.0 x 20.0 mm, 20 parts (0 on the bottom side), 17 nets.

Parts:
C1, C3, C7: 100nF; C_0603_1608Metric_Pad1.05x0.95mm_HandSolder
C2: 4.7uF; C_0603_1608Metric_Pad1.05x0.95mm_HandSolder
C4, C5: 3.3uF; C_0603_1608Metric_Pad1.05x0.95mm_HandSolder
C6, C9: 10uF; C_0603_1608Metric_Pad1.05x0.95mm_HandSolder
C8, C10: 2.7nF; C_0603_1608Metric_Pad1.05x0.95mm_HandSolder
J1: PMOD; PinHeader_1x06_P2.54mm_Horizontal
J2: AudioJack3_Ground; audio-jack
L1: 600; L_0603_1608Metric_Pad1.05x0.95mm_HandSolder
R1: 1R/1%; R_0603_1608Metric_Pad1.05x0.95mm_HandSolder
R2: R; R_0603_1608Metric_Pad1.05x0.95mm_HandSolder
R3, R4: 10K; R_0603_1608Metric_Pad1.05x0.95mm_HandSolder
R5, R6: R470; R_0603_1608Metric_Pad1.05x0.95mm_HandSolder
U1: CS4344-CZZ; SOP50P490X110-10N

Connections:
3V3: C1.1, J1.1, L1.1
GND: C1.2, C3.2, C6.2, C7.2, C8.2, C9.2, C10.2, J1.2, R1.2, R3.1, R4.1, U1.8
LRCK: J1.5, U1.3
MCLK: J1.6, U1.4
unnamed: C2.1, L1.2, R2.2
unnamed: C2.2, R1.1
unnamed: C3.1, R2.1, U1.9
unnamed: C4.1, R4.2, R5.2
unnamed: C4.2, U1.7
unnamed: C5.1, R3.2, R6.2
unnamed: C5.2, U1.10
unnamed: C6.1, U1.6
unnamed: C7.1, C9.1, U1.5
unnamed: C8.1, R6.1
unnamed: C10.1, R5.1
SCLK: J1.4, U1.2
SDIN: J1.3, U1.1
