goran-mahovlic/ulx3s-extensions/SD/SD.kicad_pcb

## KiCad design SD/SD.kicad_pcb (2018-12-15)

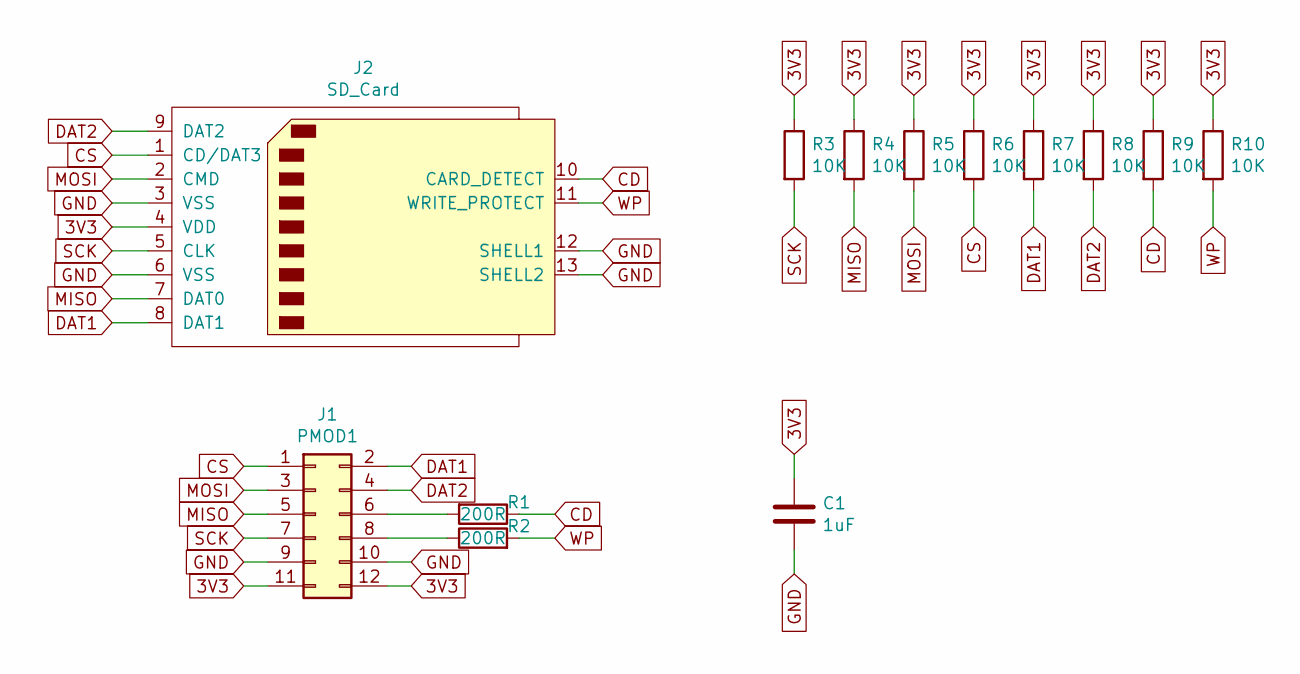
[picture p28: schematic SD.sch]

Parts:
C1: 1uF; C_0603_1608Metric_Pad1.05x0.95mm_HandSolder
J1: PMOD1; PinSocket_2x06_P2.54mm_Horizontal
J2: SD_Card; SD_Card_Receptacle
R1, R2: 200R; R_0603_1608Metric_Pad1.05x0.95mm_HandSolder
R3, R4, R5, R6, R7, R8, R9, R10: 10K; R_0603_1608Metric_Pad1.05x0.95mm_HandSolder

Connections:
3V3: C1.1, J1.11, J1.12, J2.4 (VDD), R3.1, R4.1, R5.1, R6.1, R7.1, R8.1, R9.1, R10.1
CD: J2.10 (CARD_DETECT), R1.1, R9.2
CS: J1.1, J2.1 (CD/DAT3), R6.2
DAT1: J1.2, J2.8 (DAT1), R7.2
DAT2: J1.4, J2.9 (DAT2), R8.2
GND: C1.2, J1.9, J1.10, J2.3 (VSS), J2.6 (VSS), J2.12 (SHELL1), J2.13 (SHELL2)
MISO: J1.5, J2.7 (DAT0), R4.2
MOSI: J1.3, J2.2 (CMD), R5.2
unnamed: J1.6, R1.2
unnamed: J1.8, R2.1
SCK: J1.7, J2.5 (CLK), R3.2
WP: J2.11 (WRITE_PROTECT), R2.2, R10.2

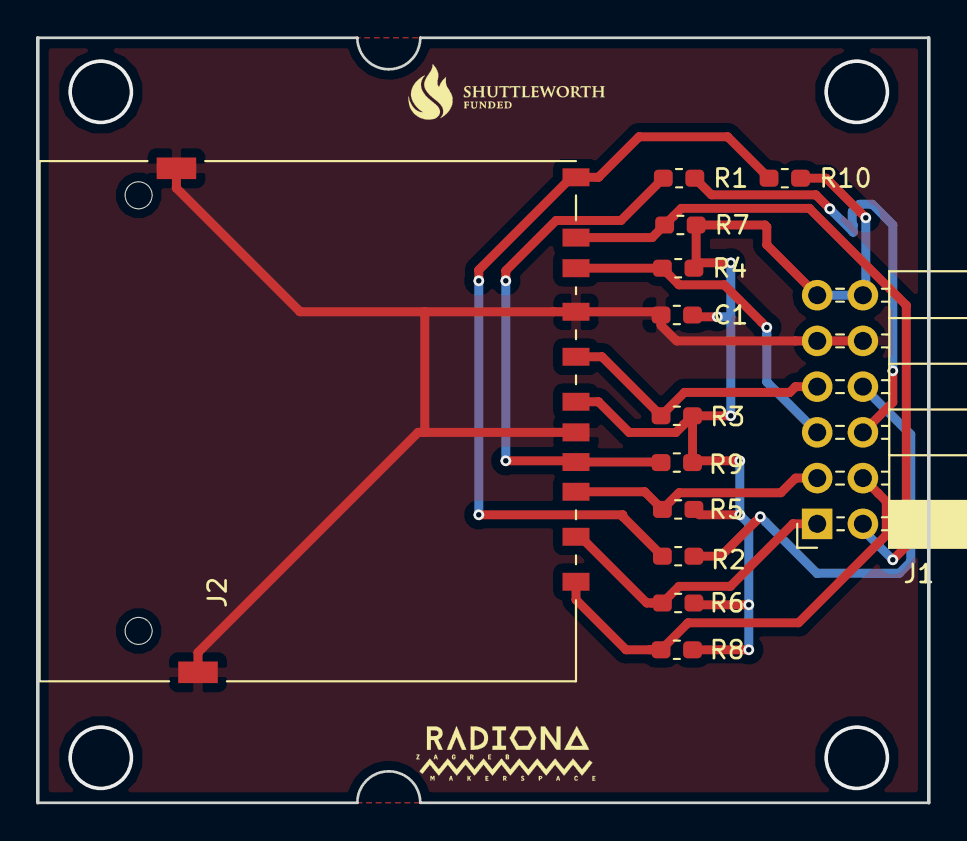
[picture p29: board SD.kicad_pcb from above]

Board: 2 copper layers, 49.5 x 42.5 mm, 13 parts (0 on the bottom side), 12 nets.
