goran-mahovlic/ulx3s-extensions/PB9/PB9.kicad_pcb

## KiCad design PB9/PB9.kicad_pcb (2018-12-15)

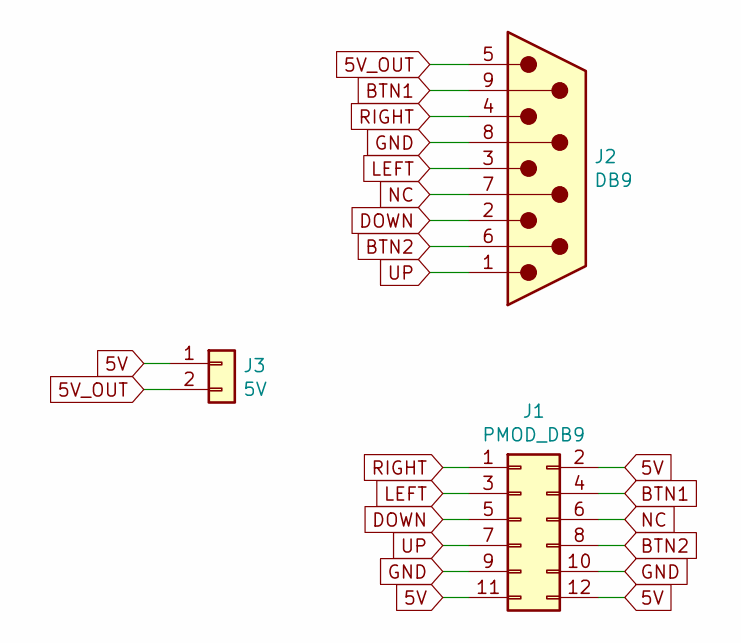
[picture p30: schematic PB9.sch]

Parts:
J1: PMOD_DB9; PinSocket_2x06_P2.54mm_Horizontal
J2: DB9; DSUB-9_Male_Horizontal_P2.77x2.54mm_EdgePinOffset9.40mm
J3: 5V; PinSocket_1x02_P2.54mm_Vertical

Connections:
5V: J1.2, J1.11, J1.12, J3.1
5V_OUT: J2.5, J3.2
BTN1: J1.4, J2.9
BTN2: J1.8, J2.6
DOWN: J1.5, J2.2
GND: J1.9, J1.10, J2.8
LEFT: J1.3, J2.3
NC: J1.6, J2.7
RIGHT: J1.1, J2.4
UP: J1.7, J2.1

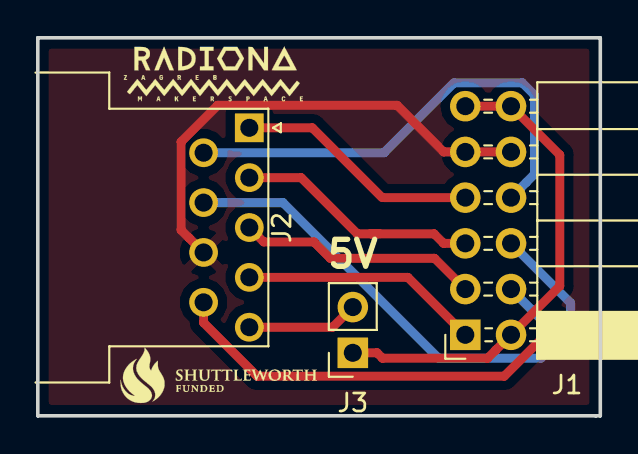
[picture p31: board PB9.kicad_pcb from above]

Board: 2 copper layers, 31.2 x 21.0 mm, 3 parts (0 on the bottom side), 10 nets.
