goran-mahovlic/ulx3s-extensions/MAX31855/MAX31855.kicad_pcb

## KiCad design MAX31855/MAX31855.kicad_pcb (2018-12-15)

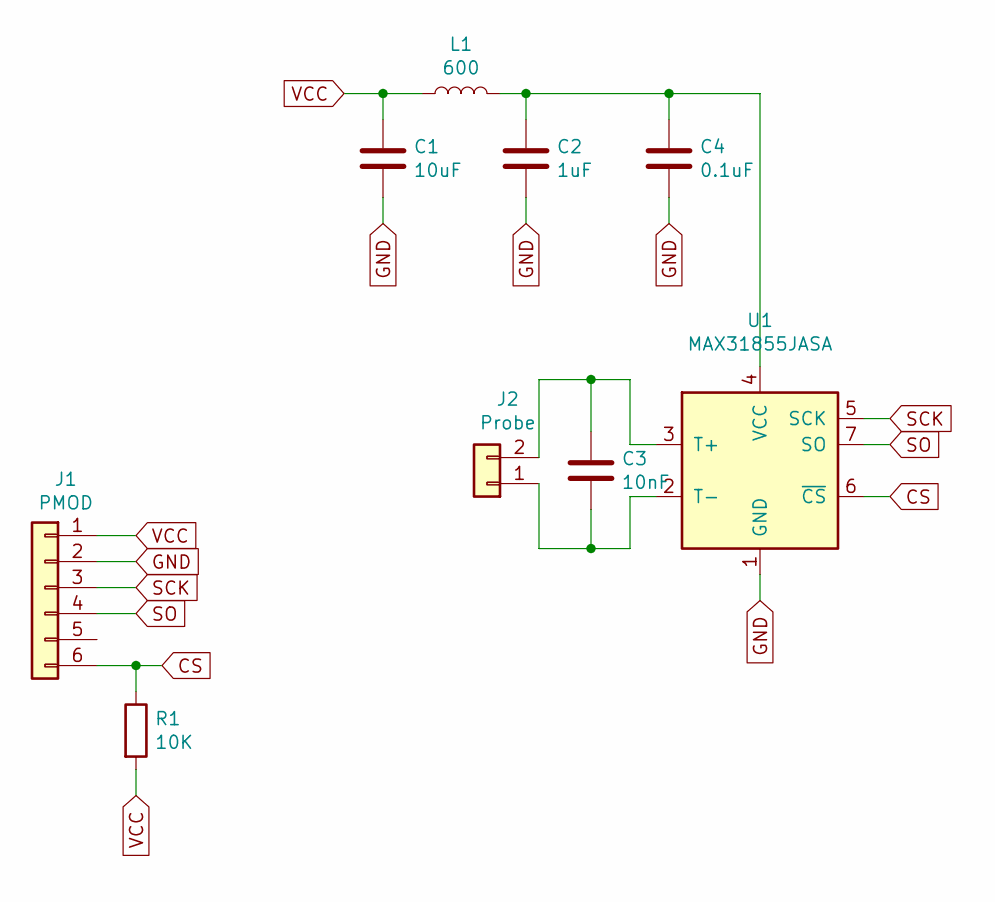
[picture p32: schematic MAX31855.sch]

Parts:
C1: 10uF; C_0603_1608Metric_Pad1.05x0.95mm_HandSolder
C2: 1uF; C_0603_1608Metric_Pad1.05x0.95mm_HandSolder
C3: 10nF; C_0603_1608Metric_Pad1.05x0.95mm_HandSolder
C4: 0.1uF; C_0603_1608Metric_Pad1.05x0.95mm_HandSolder
J1: PMOD; PinHeader_1x06_P2.54mm_Horizontal
J2: Probe; TerminalBlock_Pheonix_MPT-2.54mm_2pol
L1: 600; L_0603_1608Metric_Pad1.05x0.95mm_HandSolder
R1: 10K; R_0603_1608Metric_Pad1.05x0.95mm_HandSolder
U1: MAX31855JASA; SOIC-8_3.9x4.9mm_P1.27mm

Connections:
CS: J1.6, R1.1, U1.6 (~CS~)
GND: C1.2, C2.2, C4.2, J1.2, U1.1 (GND)
unnamed: C2.1, C4.1, L1.2, U1.4 (VCC)
unnamed: C3.1, J2.2, U1.3 (T+)
unnamed: C3.2, J2.1, U1.2 (T-)
SCK: J1.3, U1.5 (SCK)
SO: J1.4, U1.7 (SO)
VCC: C1.1, J1.1, L1.1, R1.2

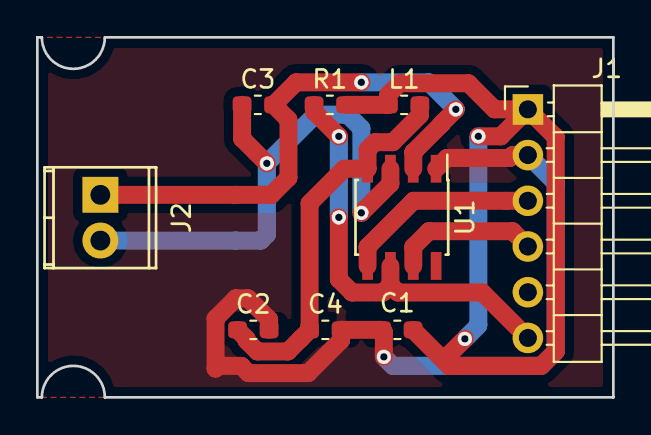
[picture p33: board MAX31855.kicad_pcb from above]

Board: 2 copper layers, 32.0 x 20.0 mm, 9 parts (0 on the bottom side), 8 nets.
