goran-mahovlic/ulx3s-extensions/(notices)

Notices in the files:
OV7670/OV7670.kicad_pcb:
License: CERN-OHL-S v2
